Jenatko/VariYO/Doc/chess.png

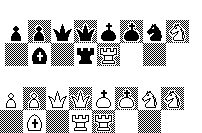
Doc/chess.png
