Jenatko/VariYO/pict/altdisp.jpg

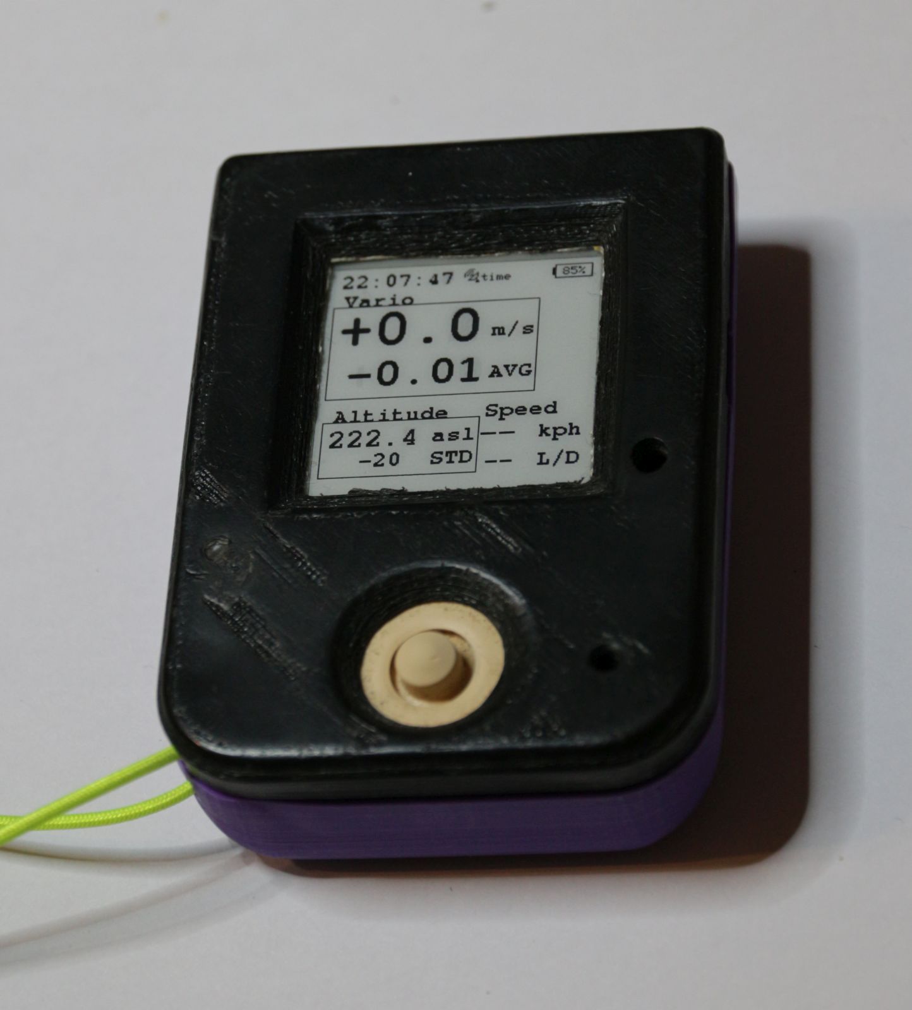
pict/altdisp.jpg
