Jenatko/VariYO/pict/chess.jpg

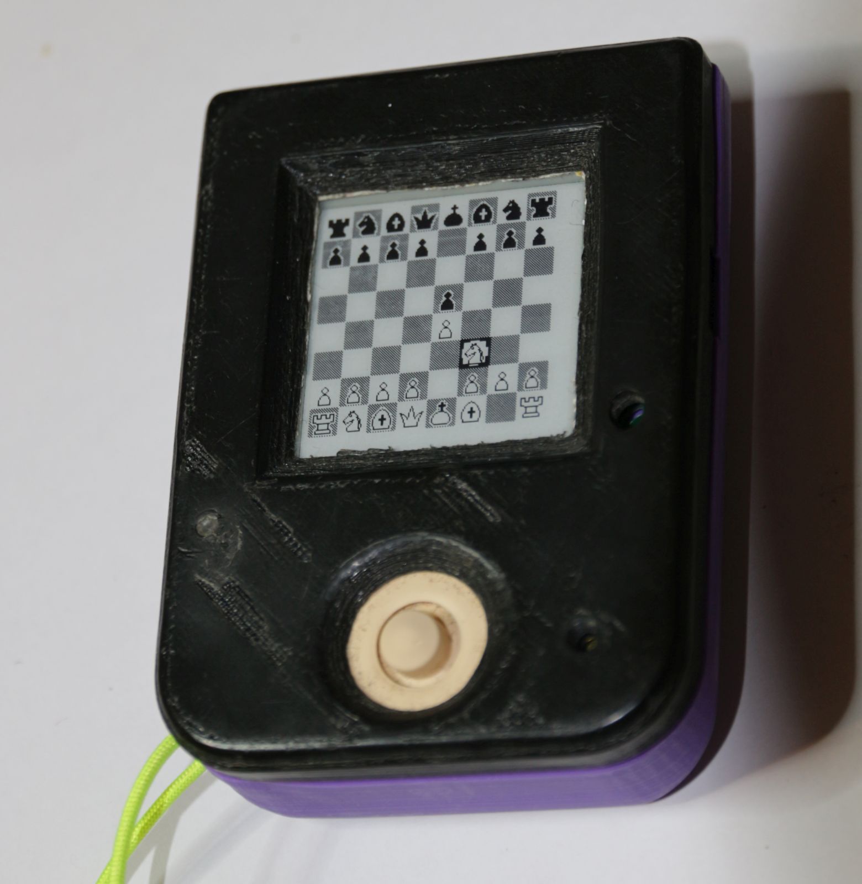
pict/chess.jpg
