Jenatko/VariYO/Hardware/bottom.STL

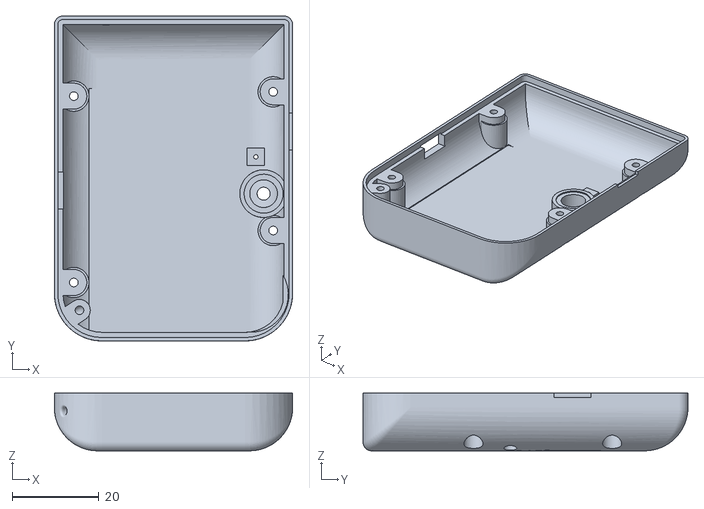
[picture p15: CAD file, 2020-01-19]
Hardware/bottom.STL
55.0 x 75.0 x 13.3
