Jenatko/VariYO/Hardware/top.STL

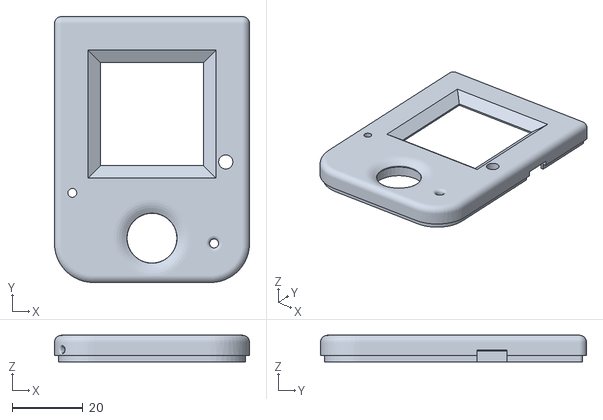
[picture p16: CAD file, 2020-01-19]
Hardware/top.STL
55.0 x 75.0 x 7.50
