Jenatko/VariYO/(list of files, cad)

Other CAD files:
Hardware/forma_joystick.dwg
