Jenatko/VariYO/(threads)

Thread 5 (2024-11-13):

Stencil for the PCB

JohnDoeAkira, 2024-11-13:
Hello,
First : Bravo for the project !
Is there any chance you could release the gerber files needed to order a stencil ?
I believe, these are GTP GBP extensions.
Cheers,
Partrick

Jenatko, 2025-04-01:
Hi, sorry for not responding. Nothing really was happening here for a long time, so i sort of stopped looking, i will have a look at it. I might have a new PCB revision altogether, so will have to somehow sync it.
