Jenatko/VariYO/(list of files, drawings)

Other design files:
Hardware/PCB/SensorsPower.SchDoc
Hardware/PCB/Vario_PCB.PrjPcb
Hardware/PCB/Vario_pcb_2l.PcbDoc
Hardware/PCB/Vario_sch.SchDoc
