Jenatko/VariYO/VarioSW_as/VarioSW/VarioSW.cpp

#include "SPI_IRQ.h"



#include <wiring_private.h>


#include "definitions.h"


#include "button_control.h"

#include "Menu.h"

#include "numpad.h"

#include "RTCZero.h"

#include "buzzer.h"

#include "roundbuff.h"

#include "routine.h"

#include "kalmanfilter3.h"

#include "MAX17055.h"

#include "EEPROM.h"

#include "Variables.h"

#include "powerModes.h"

#include <Wire.h>

#include "MEMS.h"

#include "chess.h"

#include "routine.h"

#include "Gauge.h"

#include "statvar.h"



#define ENABLE_GxEPD2_GFX 0


#include <GxEPD2_BW.h>
#define MAX_DISPAY_BUFFER_SIZE 15000ul // ~15k is a good compromise
#define MAX_HEIGHT(EPD) (EPD::HEIGHT <= MAX_DISPLAY_BUFFER_SIZE / (EPD::WIDTH / 8) ? EPD::HEIGHT : MAX_DISPLAY_BUFFER_SIZE / (EPD::WIDTH / 8))



#include <Fonts/FreeMonoBold24pt7b.h>
#include <Fonts/FreeMonoBold18pt7b.h>
#include <Fonts/FreeMonoBold12pt7b.h>
#include <Fonts/FreeMonoBold9pt7b.h>

#include "Interrupt_counter.h"

#ifdef EPAPER_V2
GxEPD2_BW<GxEPD2_154_D67, GxEPD2_154_D67::HEIGHT> display(GxEPD2_154_D67(/*CS=D8*/ PA13, /*DC=D3*/ PA14, /*RST=D4*/ PA15, /*BUSY=D2*/ PA10));
#else
GxEPD2_BW<GxEPD2_154, GxEPD2_154::HEIGHT> display(GxEPD2_154(/*CS=D8*/ PA13, /*DC=D3*/ PA14, /*RST=D4*/ PA15, /*BUSY=D2*/ PA10));
#endif




#include "SdFat.h"

SdFat SD;

#include "FlashStorage/FlashStorage.h"








volatile int counter_incremented_every_ISR = 0;




void draw_antenna(int x_oirg, int y_orig);
void draw_floppy(int x_orig, int y_orig);

int full_refresh = 0;





void displayUpdate(bool drawall = false){

	//digitalWrite(SRAM_CS, 0);




	if(ground_level != 0xffff)	statVar.AGLGauge.value[active_desktop] = (alt_filter*0.01f) - ground_level;
	else statVar.AGLGauge.value[active_desktop] = NAN;
	
	
	statVar.altitudeGauge.value[active_desktop] = (alt_filter*0.01f);
	statVar.tempGauge.value[active_desktop] = enviromental_data.temperature*0.01f;
	statVar.humidGauge.value[active_desktop] = enviromental_data.humidity;
	
	
	statVar.windGauge.value[active_desktop] = wind_speed_mps;
	statVar.windDirGauge.value[active_desktop] = wind_direction;
	
	statVar.PressureAltGauge.value[active_desktop] = getPressureAltitude();

	
	statVar.MagHdgGauge.value[active_desktop] = yaw;
	
	if(statVar.ena_vector & ENA_TRACKLOG) statVar.flightTimeGauge.value[active_desktop] = (rtc.getEpoch() - var_takeofftime)/60;
	else statVar.flightTimeGauge.value[active_desktop] = NAN;
	//statVar.altAboveTakeoffGauge = ;
	//statVar.glideRatioGauge = ;
	if(statVar.ena_vector & ENA_TRACKLOG) statVar.altAboveTakeoffGauge.value[active_desktop] = alt_filter*0.01f - var_takeoffalt*0.01f;
	else statVar.altAboveTakeoffGauge.value[active_desktop] = NAN;

	digitalWrite(SRAM_CS, 0);
	
	if(full_refresh){
		printGauges();
	}
	else
	printGauges_values();
	

	
	digitalWrite(SRAM_CS, 1);
	

	



	
	display.setCursor(10,110);
	display.setFont(&FreeMonoBold12pt7b);
	

	
	display.setFont(&FreeMonoBold12pt7b);
	
	//	display.updateWindow(0, 0, GxEPD_WIDTH, GxEPD_HEIGHT, true);
	
	//display.partiallyUpdateScreen();
	if(full_refresh)	display.display();

	else 	display.display(true);

	
	full_refresh = 0;

	
	display.fillScreen(GxEPD_WHITE);
	display.setFont(&FreeMonoBold9pt7b);
	display.setCursor(5,12);
	if(var_localtime.tm_hour < 10) display.print("0");
	display.print(var_localtime.tm_hour);
	display.print(":");
	if(var_localtime.tm_min < 10) display.print("0");
	display.print(var_localtime.tm_min);
	display.print(":");
	if(var_localtime.tm_sec < 10) display.print("0");
	display.print(var_localtime.tm_sec);

	
	display.setFont();
	
	draw_antenna(100, 0);
	display.setCursor(113,5);
	//	display.setFont();
	if(statVar.ena_vector & ENA_GPS){
		if(fix.valid.location)
		display.print("3D");
		else if(fix.valid.time)
		display.print("time");
		else
		display.print("No");
	}
	else		display.print("OFF");
	
	if(statVar.ena_vector & ENA_TRACKLOG)	draw_floppy(150, 0);
	
	
	
	
	display.setCursor(176,3);

	display.print(battery_SOC, 0);
	display.print("%");
	display.drawLine(170, 0, 198, 0, GxEPD_BLACK);
	display.drawLine(170, 12, 198, 12, GxEPD_BLACK);
	display.drawLine(170, 0, 170, 12, GxEPD_BLACK);
	display.drawLine(198, 0, 198, 12, GxEPD_BLACK);
	display.drawLine(169, 3, 169, 9, GxEPD_BLACK);
	display.drawLine(168, 3, 168, 9, GxEPD_BLACK);
	
	
	printGauges_frames();
	
	
	display.setFont(&FreeMonoBold12pt7b);


	//redraw = 0;
	
}


void setup() {
	#ifdef WAITATSETUPFORSERIAL
	while(!SerialUSB.available());
	#endif
	
	//while(!SerialUSB.available());

	
	rtc.begin();
	rtc.setTime(0, 0, 0);
	rtc.setDate(1, 1, 19);
	
	pinMode(HEAT, OUTPUT);
	digitalWrite(HEAT, 0);
	
	pinMode(POWER_ENA, OUTPUT);
	digitalWrite(POWER_ENA, POWER_OFF);
	
	pinMode(BT_UART_TX, OUTPUT);
	digitalWrite(BT_UART_TX, 0);
	
	delay(100);
	digitalWrite(POWER_ENA, POWER_ON);
	delay(50);
	
	pinMode(BUTTON_LEFT, INPUT_PULLUP);
	pinMode(BUTTON_RIGHT, INPUT_PULLUP);
	pinMode(BUTTON_UP, INPUT_PULLUP);
	pinMode(BUTTON_DOWN, INPUT_PULLUP);
	pinMode(BUTTON_CENTER, INPUT_PULLUP);


	pinMode(EEPROM_CS, OUTPUT);
	digitalWrite(EEPROM_CS, 1);


	pinMode(SRAM_CS, OUTPUT);
	digitalWrite(SRAM_CS, 1);

	pinMode(SD_CS, OUTPUT);
	digitalWrite(SD_CS, 1);

	pinMode(SD_DETECT, INPUT_PULLUP);

	pinMode(SD_RST, OUTPUT);
	digitalWrite(SD_RST, 0);


	pinMode(IMU_CS, OUTPUT);
	digitalWrite(IMU_CS, 1);
	
	pinMode(BARO_CS, OUTPUT);
	digitalWrite(BARO_CS, 1);

	pinMode(GPS_CS, OUTPUT);
	digitalWrite(GPS_CS, 1);
	
	pinMode(GPS_BCKP, OUTPUT);
	digitalWrite(GPS_BCKP, 1);

	pinPeripheral(MOSI_IRQ, PIO_SERCOM);
	pinPeripheral(MISO_IRQ, PIO_SERCOM);
	pinPeripheral(SCK_IRQ, PIO_SERCOM);



	SPI.begin();

	delay(100);   //wait for EEPROM to power-up
	

	



	
	//BT_off();

	
	present_devices = 0;
	
	


	
	if(statVar.ena_vector & (ENA_GPS)){
		if(statVar.ena_vector & (ENA_GPS_LOW_POWER)){
			GPS_low();
		}
		else{
			GPS_full();
		}
	}
	else{
		GPS_off();
	}
	

	menu_init();



	analogWrite(DAC, statVar.BuzzerVolume);
	Wire.begin();


	#ifdef SERIALDEBUG
	SerialUSB.println("Setting up display:");
	#endif

	display.init(0);
	#ifdef SERIALDEBUG
	SerialUSB.println("  init");
	#endif

	display.setFont(&FreeMonoBold12pt7b);
	#ifdef SERIALDEBUG
	SerialUSB.println("  Font");
	#endif

	display.setTextColor(GxEPD_BLACK);
	#ifdef SERIALDEBUG
	SerialUSB.println("  Text Color");
	#endif

	display.fillScreen(GxEPD_WHITE);
	#ifdef SERIALDEBUG
	SerialUSB.println("  Fill");
	#endif
	
	display.display();

	
	display.setRotation(0);
	#ifdef SERIALDEBUG
	SerialUSB.println("  rotation");
	#endif

	display.display(true);
	#ifdef SERIALDEBUG
	SerialUSB.println("  display(true)");
	#endif

	display.setTextWrap(0);
	#ifdef SERIALDEBUG
	SerialUSB.println("  text warp");
	#endif

	display.setCursor(10, 20);
	display.print("display ok");
	display.display(true);
	#ifdef SERIALDEBUG
	SerialUSB.println("  display ok");
	#endif

	display.setCursor(10, 40);
	#ifdef SERIALDEBUG
	SerialUSB.println("  Check max17055:");
	#endif

	if(max17055.checkFunct()){
		max17055.setResistSensor(0.039);
		max17055.setCapacity(1200);
		display.print("max17055 ok");
		#ifdef SERIALDEBUG
		SerialUSB.println("    max17055 ok");
		#endif
		present_devices |= MAX17055_PRESENT;
		
	}
	else{
		display.print("max17055 NOK");
		#ifdef SERIALDEBUG
		SerialUSB.println("    max17055 NOK");
		#endif

	}
	display.display(true);
	#ifdef SERIALDEBUG
	SerialUSB.println("  End check max17055k");
	#endif


	display.setCursor(10, 60);
	int errorcode = IMU_init();
	if(errorcode==0){
		display.print("BMX160 ok");
		present_devices |= BMX160_PRESENT;
		#ifdef SERIALDEBUG
		SerialUSB.println( MAG_init());
		#endif
	}
	else{
		display.print("BMX160 NOK ");
		display.print(errorcode);
		#ifdef SERIALDEBUG
		SerialUSB.println("  BMX160 NOK");
		#endif

	}
	//present_devices += BMX160_PRESENT;
	display.display(true);
	
	
	display.setCursor(10, 80);
	if(lps33_test()){
		lps33_init();
		display.print("lps33 ok");
		present_devices |= LPS33_PRESENT;
	}
	else{
		display.print("lps33 NOK");
		#ifdef SERIALDEBUG
		SerialUSB.println("lps33 NOK");
		#endif
	}
	display.display(true);
	
	
	display.setCursor(10, 100);
	if(request_si7021() == 0){
		display.print("si7021 ok");
		present_devices |= SI7021_PRESENT;
	}
	else{
		display.print("si7021 NOK");
		#ifdef SERIALDEBUG
		SerialUSB.println("  si7021 NOK");
		#endif
	}
	display.display(true);
	
	#ifdef SERIALDEBUG
	SerialUSB.println("  SD check:");
	#endif

	
	display.setCursor(10, 120);
	int ahoj;
	if(digitalRead(SD_DETECT) == 0){
		display.print("SD present ");
		#ifdef SERIALDEBUG
		SerialUSB.println("    SD present ");
		#endif
		present_devices |= SD_PRESENT;
		
		ahoj = SD.begin(SD_CS, SD_SCK_MHZ(8));
		display.print(ahoj);
		#ifdef SERIALDEBUG
		SerialUSB.println(ahoj);
		#endif
		
	}
	else{
		display.print("no SD card");
		#ifdef SERIALDEBUG
		SerialUSB.println("    no SD card");
		#endif

	}
	pinMode(SD_DETECT, INPUT);
	display.display(true);
	
load_statvar();

	
	display.setCursor(10, 140);
	
	display.print("eeprom used:");
	display.setCursor(10, 160);
	display.print(sizeof(statVar));
	display.print("/");
	display.print(4096/8/sizeof(char));
	
	display.display(true);
	
	display.setCursor(10, 180);
	display.print(__DATE__);
	display.display(true);
	
	
	
	


	delay(1000);
	while(!digitalRead(BUTTON_CENTER));
	
	
	#ifdef SERIALDEBUG
	SerialUSB.println("  Buzzer");
	#endif
	

	buzzerInit();


	
	counterInit();
	
	delay(1000);
	
	
	//setVariablesDefault();

	#ifdef SERIALDEBUG
	SerialUSB.println("  kalman filter");
	#endif


	kalmanFilter3_configure(statVar.zvariance*1.0f, statVar.accelvariance*1000.0f, 1.0f, alt_baro*1.0f, 0.0f , 0.0f);
	
	vario_lowpassed_600samples = 0;

	
	

	#ifdef SERIALDEBUG
	SerialUSB.println("Setup done.");
	#endif
	
	debugflag = 0;


}



void loop() {


	while (buttons.getFlag()){
		switch (buttons.getButtonPressed()){
			case PRESS:
			MenuEntry(&topmenu);
			display.fillScreen(GxEPD_WHITE);

			//	displayUpdate(true);
			//	display.display();
			full_refresh = 1;
			break;
			
			case DOWN:
			statVar.BuzzerVolume -=30;
			if(statVar.BuzzerVolume<=0){
				statVar.BuzzerVolume = 0;
				
			}
			buzzerSetVolume(statVar.BuzzerVolume);
			break;
			
			case UP:
			statVar.BuzzerVolume +=30;
			if(statVar.BuzzerVolume>255){
				statVar.BuzzerVolume = 255;
				
			}
			buzzerSetVolume(statVar.BuzzerVolume);
			break;
			case LEFT:
			active_desktop--;
			if(active_desktop<0){
				active_desktop = NUM_DESKTOPS - 1;
				
			}
			break;
			case RIGHT:
			active_desktop++;
			if(active_desktop>NUM_DESKTOPS-1){
				active_desktop = 0;
				
			}
			
			buzzerSetVolume(statVar.BuzzerVolume);
			break;
		}

	}
	
	uint64_t t_start_first = micros();
	routine(0);
	uint64_t t_stop_first = micros();
	//	SerialUSB.println((uint32_t)((t_stop-t_start)/1000));


	if(digitalRead(DISP_BUSY) == 0){
		time_t tempTime = rtc.getEpoch();
		tempTime += 3600 * statVar.TimeZone;
		var_localtime = *gmtime(&tempTime);
		
		
		t_start_first = micros();
		
		displayUpdate();
		t_stop_first = micros();
	}
	else{
		delay(10);
	}
}


void draw_antenna(int x_orig, int y_orig){
	display.drawLine(x_orig + 4, y_orig, x_orig + 7, y_orig, GxEPD_BLACK);
	display.drawLine(x_orig, y_orig+4, x_orig, y_orig+7, GxEPD_BLACK);
	display.drawLine(x_orig+1, y_orig+3, x_orig+3, y_orig+1, GxEPD_BLACK);
	
	display.drawLine(x_orig+2, y_orig+5, x_orig+5, y_orig+2, GxEPD_BLACK);
	display.drawPixel(x_orig+2, y_orig+6, GxEPD_BLACK);
	display.drawPixel(x_orig+6, y_orig+2, GxEPD_BLACK);
	
	display.drawLine(x_orig+6, y_orig+4, x_orig+4, y_orig+6, GxEPD_BLACK);
	
	display.drawLine(x_orig+10, y_orig+3, x_orig+3, y_orig+10, GxEPD_BLACK);
	display.drawLine(x_orig+10, y_orig+4, x_orig+10, y_orig+7, GxEPD_BLACK);
	display.drawLine(x_orig+4, y_orig+10, x_orig+7, y_orig+10, GxEPD_BLACK);
	
	display.drawPixel(x_orig+11, y_orig+11, GxEPD_BLACK);
	display.drawPixel(x_orig+10, y_orig+10, GxEPD_BLACK);
	display.drawPixel(x_orig+10, y_orig+11, GxEPD_BLACK);
	display.drawPixel(x_orig+9, y_orig+11, GxEPD_BLACK);
	display.drawPixel(x_orig+9, y_orig+9, GxEPD_BLACK);
	display.drawPixel(x_orig+9, y_orig+8, GxEPD_BLACK);
	display.drawPixel(x_orig+8, y_orig+9, GxEPD_BLACK);
	display.drawPixel(x_orig+6, y_orig+6, GxEPD_BLACK);
	display.drawPixel(x_orig+11, y_orig+12, GxEPD_BLACK);
	display.drawPixel(x_orig+10, y_orig+12, GxEPD_BLACK);
	display.drawPixel(x_orig+9, y_orig+12, GxEPD_BLACK);
}

void draw_floppy(int x_orig, int y_orig){
	display.drawLine(x_orig, y_orig, x_orig + 11, y_orig, GxEPD_BLACK);
	display.drawLine(x_orig, y_orig, x_orig, y_orig+10, GxEPD_BLACK);
	display.drawLine(x_orig+11, y_orig, x_orig + 11, y_orig+11, GxEPD_BLACK);
	display.drawLine(x_orig+1, y_orig+11, x_orig + 11, y_orig+11, GxEPD_BLACK);
	display.drawLine(x_orig+2, y_orig+1, x_orig + 2, y_orig+6, GxEPD_BLACK);
	display.drawLine(x_orig+9, y_orig+1, x_orig + 9, y_orig+6, GxEPD_BLACK);
	display.drawLine(x_orig+2, y_orig+6, x_orig + 9, y_orig+6, GxEPD_BLACK);
	
	display.drawLine(x_orig+3, y_orig+8, x_orig + 8, y_orig+8, GxEPD_BLACK);
	display.drawPixel(x_orig+3, y_orig+9, GxEPD_BLACK);
	display.drawPixel(x_orig+3, y_orig+10, GxEPD_BLACK);
	display.drawPixel(x_orig+6, y_orig+9, GxEPD_BLACK);
	display.drawPixel(x_orig+6, y_orig+10, GxEPD_BLACK);
	display.drawPixel(x_orig+7, y_orig+10, GxEPD_BLACK);
	display.drawPixel(x_orig+7, y_orig+9, GxEPD_BLACK);
	display.drawPixel(x_orig+8, y_orig+9, GxEPD_BLACK);
	display.drawPixel(x_orig+8, y_orig+10, GxEPD_BLACK);

}
