Jenatko/VariYO/Serial/serial_reader/serial_plotter.py

from PyQt5.QtGui import QIntValidator
from PyQt5.QtWidgets import QGridLayout, QApplication, QPushButton, QLineEdit
from qtpy import QtWidgets

from matplot_vidgets import MplWidget
import serial

import numpy as np


class SerialPlotter(QtWidgets.QWidget):

    FREQ = 4800

    def __init__(self, port=None):
        super(SerialPlotter, self).__init__()

        self.setLayout(QGridLayout(self))

        self.grid = []

        self.mpl = MplWidget(dpi=100)
        self.mpl.toolbar.show()
        self.layout().addWidget(self.mpl, 0, 0)

        self.iterationsLabel = QLineEdit()
        self.iterationsLabel.setText('600')
        self.iterationsLabel.setValidator(QIntValidator(0,1000))
        self.layout().addWidget(self.iterationsLabel, 1, 0)

        button = QPushButton('Read shit!')
        button.clicked.connect(self.read)
        self.layout().addWidget(button, 2, 0)

        self.port = port

    def check_connection(self):

        if self.port is None:
            port, flag = self.scan_connections()
            if flag:
                self.port = port
                return True
            else:
                print('Vario not connected.')
                return False
        else:
            return True

    def read(self):

        if not self.check_connection():
            return

        iterations = int(self.iterationsLabel.text())

        with serial.Serial(self.port, self.FREQ, timeout=5) as ser:
            print('Vario connected at port:', self.port)
            cache = []
            try:
                for i in range(iterations):
                    line = ser.readline()
                    if line:
                        print(line.strip())
                        cache.append(float(line))
                    else:
                        print('Reading data failed.')
                        return

            except Exception as ex:
                print(ex)

            if len(cache) > 1:
                std = np.std(cache)
                self.mpl.sc.axes.plot(cache, label='std = {:0.3e}'.format(std))
                self.mpl.sc.fig.legend()
                self.mpl.sc.draw()
            else:
                print('Reading data failed.')

    def scan_connections(self):

        flag_found = False
        print("Looking for ports.")
        for i in range(2, 30):
            COM0 = "COM" + repr(i)
            print("\tConnecting to port {:s}...".format(COM0), end='')
            try:
                ser = serial.Serial(COM0, self.FREQ)
                ser.close()
            except Exception as ex:
                print("Not this one.")
            else:
                flag_found = True
                print("Found open port: ", COM0)
                break
        print("Done.\n")
        if flag_found:
            print("Found open port: ", COM0)
        else:
            print('No port available.')
        return COM0, flag_found


if __name__ == "__main__":

    import sys

    port = None
    if len(sys.argv) > 1:
        port = sys.argv[1]

    app = QApplication([])

    window = SerialPlotter(port)
    window.show()
    sys.exit(app.exec_())
