Jenatko/VariYO/VarioSW_as/VarioSW/src/periph/MAX17055.cpp

/**********************************************************************
*
* MIT License
*
* Copyright (c) 2018 Awot Ghirmai
*
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
* Authors:
* Awot Ghirmai; ghirmai.awot@gmail.com
* Ole Dreessen; ole.dreessen@maximintegrated.com
*
**********************************************************************/


#include <MAX17055.h>
#include <Wire.h>
 
 
 /**********************************************************************
 * @brief MAX17055 - The MAX17055 is a low 7?A operating current fuel gauge that implements
 * Maxim ModelGauge™ m5 EZ algorithm. ModelGauge m5 EZ makes fuel gauge implementation
 * easy by eliminating battery characterization requirements and simplifying host software interaction.
 * The ModelGauge m5 EZ robust algorithm provides tolerance against battery diversity for most
 * lithium batteries and applications. ModelGauge m5 EZ algorithm combines the short-term
 * accuracy and linearity of a coulomb counter with the longterm stability of a voltage-based fuel
 * gauge, along with temperature compensation to provide industry-leading fuel gauge accuracy.
 * The MAX17055 automatically compensates for cell aging, temperature, and discharge rate, and
 * provides accurate state of charge (SOC in %) and remaining capacity in milliampere-hours (mAh).
 * As the battery approaches the critical region near empty, the ModelGauge m5 algorithm invokes
 * a special compensation that eliminates any error. It also provides three methods for reporting
 * the age of the battery: reduction in capacity, increase in battery resistance, and cycle odometer.
 * The MAX17055 provides precision measurements of current, voltage, and temperature. Temperature
 * of the battery pack is measured using an internal temperature measurement or external thermistor.
 * A 2-wire I2C interface provides access to data and control registers. The MAX17055 is available
 * in a tiny, lead-free 0.4mm pitch 1.4mm x 1.5mm, 9-pin WLP package, and a 2mm x 2.5mm, 10-pin
 * TDFN package.
 *
 * Ressources can be found at
 * https://www.maximintegrated.com/en/products/power/battery-management/MAX17055.html
 * https://www.maximintegrated.com/en/app-notes/index.mvp/id/6365
 * https://www.maximintegrated.com/en/app-notes/index.mvp/id/6358
 **********************************************************************/


// Constructors 
MAX17055::MAX17055(void)


  
{
	//doesn't need anything here
}

MAX17055::MAX17055(uint16_t batteryCapacity)
{
	//calcuation based on AN6358 page 13 figure 1.3 for Capacity, but reversed to get the register value 
		writeReg16Bit(ModelCFG, 0);
	writeReg16Bit(DesignCap, batteryCapacity*2);
}
// Public Methods
void MAX17055::setCapacity(uint16_t batteryCapacity)
{
			writeReg16Bit(ModelCFG, 0x8000);
	//calcuation based on AN6358 page 13 figure 1.3 for Capacity, but reversed to get the register value 
	writeReg16Bit(DesignCap, batteryCapacity / capacity_multiplier_mAH);	
}	

float MAX17055::getCapacity()
{
   	// uint16_t capacity_raw = readReg16Bit(RepCap);
   	uint16_t capacity_raw = readReg16Bit(DesignCap);
	return (capacity_raw * capacity_multiplier_mAH);
}

	float MAX17055::getReportedCapacity()
{
	// uint16_t capacity_raw = readReg16Bit(RepCap);
	uint16_t capacity_raw = readReg16Bit(FullCapRep);
	return (capacity_raw * capacity_multiplier_mAH);
}	
	
	float MAX17055::getRemainingCapacity()
{
	// uint16_t capacity_raw = readReg16Bit(RepCap);
	uint16_t capacity_raw = readReg16Bit(RepCap);
	return (capacity_raw * capacity_multiplier_mAH);
}

void MAX17055::setResistSensor(float resistorValue)
{
	resistSensor = resistorValue;
	 capacity_multiplier_mAH = (5e-3)/resistSensor; //refer to row "Capacity"
	 current_multiplier_mV = (1.5625e-3)/resistSensor; //refer to row "Current"
	 voltage_multiplier_V = 7.8125e-5; //refer to row "Voltage"
	 time_multiplier_Hours = 5.625/3600.0; //Least Significant Bit= 5.625 seconds, 3600 converts it to Hours. refer to AN6358 pg 13 figure 1.3 in row "Time"
	 percentage_multiplier = 1.0/256.0; //refer to row "Percentage"
}

float MAX17055::getResistSensor()
{
	return resistSensor;
}

float MAX17055::getInstantaneousCurrent()
{
   	int16_t current_raw = readReg16Bit(Current);
	return current_raw * current_multiplier_mV;
}

float MAX17055::getAverageCurrent()
{
	int16_t current_raw = readReg16Bit(AvgCurrent);
	return current_raw * current_multiplier_mV;
}

float MAX17055::getInstantaneousVoltage()
{
   	uint16_t voltage_raw = readReg16Bit(VCell);
	return voltage_raw * voltage_multiplier_V;
}

float MAX17055::getAverageVoltage()
{
	uint16_t voltage_raw = readReg16Bit(AvgVCell);
	return voltage_raw * voltage_multiplier_V;
}

float MAX17055::getSOC()
{
   	uint16_t SOC_raw = readReg16Bit(RepSOC);
	return SOC_raw * percentage_multiplier;
}

float MAX17055::getTimeToEmpty()
{
	uint16_t TTE_raw = readReg16Bit(TimeToEmpty);
	return TTE_raw * time_multiplier_Hours;
}

float MAX17055::getTimeToFull()
{
	uint16_t TTE_raw = readReg16Bit(TimeToFull);
	return TTE_raw * time_multiplier_Hours;
}

float MAX17055::getTemp()
{
	int16_t TTE_raw = readReg16Bit(Temp);
	return TTE_raw/256.0;
}

float MAX17055::getVFSOC(){
   	uint16_t SOC_raw = readReg16Bit(VFSOC);
   	return SOC_raw * percentage_multiplier;
	
}

int MAX17055::checkFunct(){
writeReg16Bit(Rsense, 0xaabb);
int readvalue = readReg16Bit(Rsense);
if(readvalue == 0xaabb)
return 1;
else
return 0;
}



// Private Methods

void MAX17055::writeReg16Bit(uint8_t reg, uint16_t value)
{
  //Write order is LSB first, and then MSB. Refer to AN635 pg 35 figure 1.12.2.5
  Wire.beginTransmission(I2CAddress);
  Wire.write(reg);
  Wire.write( value       & 0xFF); // value low byte
  Wire.write((value >> 8) & 0xFF); // value high byte
  uint8_t last_status = Wire.endTransmission();
}

uint16_t MAX17055::readReg16Bit(uint8_t reg)
{
  uint16_t value = 0;  
  Wire.beginTransmission(I2CAddress); 
  Wire.write(reg);
  uint8_t last_status = Wire.endTransmission(false);
  
  Wire.requestFrom(I2CAddress, (uint8_t) 2); 
  value  = Wire.read();
  value |= (uint16_t)Wire.read() << 8;      // value low byte
  return value;
}

MAX17055 max17055;
