Jenatko/VariYO/VarioSW_as/ArduinoCore/src/core/wiring_digital.c

/*
  Copyright (c) 2015 Arduino LLC.  All right reserved.

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
  You should have received a copy of the GNU Lesser General Public
  License along with this library; if not, write to the Free Software
  Foundation, Inc., 51 Franklin St, Fifth Floor, Boston, MA  02110-1301  USA
*/

#include "Arduino.h"

#ifdef __cplusplus
 extern "C" {
#endif

void pinMode( uint32_t ulPin, uint32_t ulMode )
{
  // Handle the case the pin isn't usable as PIO
  if ( g_APinDescription[ulPin].ulPinType == PIO_NOT_A_PIN )
  {
    return ;
  }

  // Set pin mode according to chapter '22.6.3 I/O Pin Configuration'
  switch ( ulMode )
  {
    case INPUT:
      // Set pin to input mode
      PORT->Group[g_APinDescription[ulPin].ulPort].PINCFG[g_APinDescription[ulPin].ulPin].reg=(uint8_t)(PORT_PINCFG_INEN) ;
      PORT->Group[g_APinDescription[ulPin].ulPort].DIRCLR.reg = (uint32_t)(1<<g_APinDescription[ulPin].ulPin) ;
    break ;

    case INPUT_PULLUP:
      // Set pin to input mode with pull-up resistor enabled
      PORT->Group[g_APinDescription[ulPin].ulPort].PINCFG[g_APinDescription[ulPin].ulPin].reg=(uint8_t)(PORT_PINCFG_INEN|PORT_PINCFG_PULLEN) ;
      PORT->Group[g_APinDescription[ulPin].ulPort].DIRCLR.reg = (uint32_t)(1<<g_APinDescription[ulPin].ulPin) ;

      // Enable pull level (cf '22.6.3.2 Input Configuration' and '22.8.7 Data Output Value Set')
      PORT->Group[g_APinDescription[ulPin].ulPort].OUTSET.reg = (uint32_t)(1<<g_APinDescription[ulPin].ulPin) ;
    break ;

    case INPUT_PULLDOWN:
      // Set pin to input mode with pull-down resistor enabled
      PORT->Group[g_APinDescription[ulPin].ulPort].PINCFG[g_APinDescription[ulPin].ulPin].reg=(uint8_t)(PORT_PINCFG_INEN|PORT_PINCFG_PULLEN) ;
      PORT->Group[g_APinDescription[ulPin].ulPort].DIRCLR.reg = (uint32_t)(1<<g_APinDescription[ulPin].ulPin) ;

      // Enable pull level (cf '22.6.3.2 Input Configuration' and '22.8.6 Data Output Value Clear')
      PORT->Group[g_APinDescription[ulPin].ulPort].OUTCLR.reg = (uint32_t)(1<<g_APinDescription[ulPin].ulPin) ;
    break ;

    case OUTPUT:
      // Set pin to output mode
      PORT->Group[g_APinDescription[ulPin].ulPort].PINCFG[g_APinDescription[ulPin].ulPin].reg&=~(uint8_t)(PORT_PINCFG_INEN) ;
	  PORT->Group[g_APinDescription[ulPin].ulPort].DIRSET.reg = (uint32_t)(1<<g_APinDescription[ulPin].ulPin) ;
	  PORT->Group[g_APinDescription[ulPin].ulPort].PINCFG[g_APinDescription[ulPin].ulPin].bit.DRVSTR = 1;


    break ;

    default:
      // do nothing
    break ;
  }
}

void digitalWrite( uint32_t ulPin, uint32_t ulVal )
{
  // Handle the case the pin isn't usable as PIO
  if ( g_APinDescription[ulPin].ulPinType == PIO_NOT_A_PIN )
  {
    return ;
  }

  // Enable pull-up resistor
  PORT->Group[g_APinDescription[ulPin].ulPort].PINCFG[g_APinDescription[ulPin].ulPin].reg=(uint8_t)(PORT_PINCFG_PULLEN) ;

  switch ( ulVal )
  {
    case LOW:
      PORT->Group[g_APinDescription[ulPin].ulPort].OUTCLR.reg = (1ul << g_APinDescription[ulPin].ulPin) ;
    break ;

    default:
      PORT->Group[g_APinDescription[ulPin].ulPort].OUTSET.reg = (1ul << g_APinDescription[ulPin].ulPin) ;
    break ;
  }

  return ;
}

int digitalRead( uint32_t ulPin )
{
  // Handle the case the pin isn't usable as PIO
  if ( g_APinDescription[ulPin].ulPinType == PIO_NOT_A_PIN )
  {
    return LOW ;
  }

  if ( (PORT->Group[g_APinDescription[ulPin].ulPort].IN.reg & (1ul << g_APinDescription[ulPin].ulPin)) != 0 )
  {
    return HIGH ;
  }

  return LOW ;
}

#ifdef __cplusplus
}
#endif
