Jenatko/VariYO/VarioSW_as/VarioSW/src/Variables.h

/*
* Variables.h
*
* Created: 1.12.2018 16:55:05
*  Author: Jena
*/
#include <Arduino.h>
#include <time.h>
#include <bme280_defs.h>


#include "lib/CircleFit/circle.h"
#include "lib/CircleFit/data.h"
#include "definitions.h"


#ifndef VARIABLES_H_
#define VARIABLES_H_





typedef struct Gauge{
	float value[NUM_DESKTOPS];
	uint16_t settings[NUM_DESKTOPS];
	uint8_t size_X[NUM_DESKTOPS];
	uint8_t size_Y[NUM_DESKTOPS];
	uint8_t offset_X[NUM_DESKTOPS];
	uint8_t offset_Y[NUM_DESKTOPS];
	char name_shown[NUM_DESKTOPS][10];
	char units[NUM_DESKTOPS][4];
	uint16_t averaging[NUM_DESKTOPS];
} Gauge;



typedef struct StaticVariables{
	int8_t valid;
	int16_t th_rise;
	int16_t th_sink;
	int8_t ena_vector;
	int16_t BuzzerVolume;
	int8_t TimeZone;
	
	//MS5611 baro
	float Psea;
	
	
	//IMU
	float gainErrorAccelX;
	int16_t offsetAccelX;
	float gainErrorAccelY;
	int16_t offsetAccelY;
	float gainErrorAccelZ;
	int16_t offsetAccelZ;
	
	int gainErrorMagX;
	int offsetMagX;
	int gainErrorMagY;
	int offsetMagY;
	int gainErrorMagZ;
	int offsetMagZ;
	

	
	float zvariance, accelvariance;
	Gauge varioGauge;
	Gauge varioAvgGauge;
	Gauge altitudeGauge;
	Gauge AGLGauge;
	Gauge speedGauge;
	Gauge headingGauge;
	Gauge tempGauge;
	Gauge humidGauge;
	Gauge windGauge;
	Gauge windDirGauge;
	Gauge glideRatioGauge;
	Gauge flightTimeGauge;
	Gauge altAboveTakeoffGauge;
	Gauge PressureAltGauge;
	Gauge MagHdgGauge;
	
	
} StaticVariables;

struct enviroData {
	/*! Compensated pressure */
	uint32_t pressure;
	/*! Compensated temperature */
	int32_t temperature;
	/*! Compensated humidity */
	uint32_t humidity;
};


extern int active_desktop ;

extern double myRealAltitude;
extern volatile float altChange, vario_lowpassed_600samples;
//extern int redraw;
extern volatile int ax, ay, az, ax_corr, ay_corr, az_corr, gx, gy, gz, ax_avg, ay_avg, az_avg, gx_avg, gy_avg, gz_avg, mx, my, mz, mx_cor, my_cor, mz_cor, axmax, aymax, azmax, gxmax, gymax, gzmax, axmin, aymin, azmin, gxmin, gymin, gzmin, debugflag;
extern float yaw, pitch, roll;
extern float a_vertical_imu, alt_filter, vario_filter, alt_baro;

extern int tracklog_stat;
//extern struct tm*  var_localtime;
extern struct tm  var_localtime;
extern time_t  var_takeofftime;
extern int var_takeoffalt;
extern float g_meter;
extern int ground_level, ground_level2;
extern int PerformRoutineInWaitWhileBusy;
extern int position_updated;
extern int serialDebugVector;


extern float ground_level_interpol;

extern uint8_t present_devices;

extern float battery_voltage, battery_SOC;

extern int logger_ena;

extern int maxalt ;
extern int minalt ;
extern int maxrise10s;
extern int minsink10s ;


//for debugging, can be moved to their proper scope after
extern int x1y1, x2y1, x1y2, x2y2, alt11, alt12, alt21, alt22;
extern float fractx, fracty, x1inter, x2inter, interpolation;
extern float lat_dr, lon_dr;



//variables for counting wind
extern float wind_speed_mps;
extern float wind_direction;
extern Data movement_vector_data;
extern Circle movement_circle_fit;


//structure containng pressure, humidity and temperature
extern struct enviroData enviromental_data;



extern StaticVariables statVar;

void setVariablesDefault(void);


#endif /* VARIABLES_H_ */
