Jenatko/VariYO/VarioSW_as/VarioSW/src/periph/BMI160/BMI160Gen.cpp

#include "BMI160Gen.h"
//#include "SPI.h"
#include "SPI_IRQ.h"
#include "Wire.h"

//#define DEBUG

bool BMI160GenClass::begin(const int spi_cs_pin, const int intr_pin)
{
	return begin(SPI_MODE, spi_cs_pin, intr_pin);
}

bool BMI160GenClass::begin(Mode mode, const int arg1, const int arg2)
{
	this->mode = mode;
	switch (this->mode) {
		case INVALID_MODE:

		return false;
		case I2C_MODE:
		i2c_addr = arg1;
		break;
		case SPI_MODE:

		spi_ss = arg1;
		break;
		default:

		return false;
	}
	if (0 <= arg2) {

		interrupt_pin = digitalPinToInterrupt(arg2);
		#ifdef DEBUG
		#endif
	}
	
	return CurieIMUClass::begin();
}

void BMI160GenClass::attachInterrupt(void (*callback)(void))
{
	CurieIMUClass::attachInterrupt(NULL);
	if (0 <= interrupt_pin) {
		::attachInterrupt(interrupt_pin, callback, FALLING);
		} else {
		Serial.println("BMI160GenClass::attachInterrupt: No valid interruption pin.");
	}
}

void BMI160GenClass::ss_init()
{	
	

	switch (this->mode) {
		case I2C_MODE:

		i2c_init();
		break;
		case SPI_MODE:


		spi_init();
		break;
		default:


		break;
	}
}

int BMI160GenClass::ss_xfer(uint8_t *buf, unsigned tx_cnt, unsigned rx_cnt)
{
	switch (this->mode) {
		case I2C_MODE:
		return i2c_xfer(buf, tx_cnt, rx_cnt);
		case SPI_MODE:
		if (rx_cnt) /* For read transfers, assume 1st byte contains register address */
		buf[0] |= (1 << BMI160_SPI_READ_BIT);
		return spi_xfer(buf, tx_cnt, rx_cnt);
		default:
		return 0;
	}
}

void BMI160GenClass::i2c_init()
{
	#ifdef DEBUG
	Serial.println("BMI160GenClass::i2c_init()...");
	#endif // DEBUG

	Wire.begin();
	Wire.beginTransmission(i2c_addr);
	if( Wire.endTransmission() != 0 )
	Serial.println("BMI160GenClass::i2c_init(): I2C failed.");

	#ifdef DEBUG
	int id = getDeviceID();
	Serial.print("BMI160GenClass::i2c_init(): CHIP ID = 0x");
	Serial.println(id, HEX);
	Serial.println("BMI160GenClass::i2c_init()...done");
	#endif // DEBUG
}

int BMI160GenClass::i2c_xfer(uint8_t *buf, unsigned tx_cnt, unsigned rx_cnt)
{
	uint8_t *p;

	#ifdef DEBUG
	Serial.print("i2c_xfer(offs=0x");
	Serial.print(*buf, HEX);
	Serial.print(", tx=");
	Serial.print(tx_cnt);
	Serial.print(", rx=");
	Serial.print(rx_cnt);
	Serial.print("):");
	#endif // DEBUG

	Wire.beginTransmission(i2c_addr);
	p = buf;
	while (0 < tx_cnt) {
		tx_cnt--;
		Wire.write(*p++);
	}
	if( Wire.endTransmission() != 0 ) {
		Serial.println("Wire.endTransmission() failed.");
	}
	if (0 < rx_cnt) {
		Wire.requestFrom(i2c_addr, rx_cnt);
		p = buf;
		while ( Wire.available() && 0 < rx_cnt) {
			rx_cnt--;
			#ifdef DEBUG
			int t = *p++ = Wire.read();
			Serial.print(" ");
			Serial.print(t, HEX);
			#else
			*p++ = Wire.read();;
			#endif // DEBUG
		}
	}

	#ifdef DEBUG
	Serial.println("");
	#endif // DEBUG

	return (0);
}

void BMI160GenClass::spi_init()
{
	#ifdef DEBUG
	SerialUSB.println("BMI160GenClass::spi_init()...");
	#endif // DEBUG


	// start the SPI library:
	//SPI_IRQ.begin();
	if (0 <= spi_ss) {
		pinMode(spi_ss, OUTPUT);
		} else {
		Serial.println("BMI160GenClass::spi_init(): WARNING: No chip select pin specified.");
	}


	#ifdef DEBUG
	Serial.println("BMI160GenClass::spi_init()...done");
	#endif // DEBUG
}

int BMI160GenClass::spi_xfer(uint8_t *buf, unsigned tx_cnt, unsigned rx_cnt)
{	
	SPI_IRQ.beginTransaction(SPISettings(1000000, MSBFIRST, SPI_MODE3));
	uint8_t *p;
	





	if (0 <= spi_ss)
	digitalWrite(spi_ss, LOW);
	p = buf;
	while (0 < tx_cnt) {
		tx_cnt--;
		SPI_IRQ.transfer(*p++);

	}
	p = buf;
	while (0 < rx_cnt) {
		rx_cnt--;
		#ifdef DEBUG
		int t = *p++ = SPI_IRQ.transfer(0);
		Serial.print(" ");
		Serial.print(t, HEX);
		#else
		*p++ = SPI_IRQ.transfer(0);
		#endif // DEBUG
	}
	if (0 <= spi_ss)
	digitalWrite(spi_ss, HIGH);

	#ifdef DEBUG
	Serial.println("");
	#endif // DEBUG

	return (0);
}

BMI160GenClass BMI160;
