Jenatko/VariYO/VarioSW_as/VarioSW/ToDo.h

/*
 * ToDo.h
 *
 * Created: 18.5.2019 21:59:51
 *  Author: Jena
 */ 


#ifndef TODO_H_
#define TODO_H_

/*

printing to display is SLOOOOOOOOWWWWW!!!!
nothing with bluetooth is done yet
some XContest compatible tracklog format (or convert on pc?)
display heating  --partially done, maybe some automatic mode?
airspaces? there is some open airspace format, maybe with that
alarm, stopwatch, countdown timer
chess is super lame, maybe some exit button, not returning when king is taken:-)
temperature/humdity logger
gps to galileo instead of beidou?
turning off all the unnecessary shit in microcontroller would be handy to reduce consumption
check why MAX17055 doesnt indicate SOC 100%
altitude above take-off
compass (indicating towards horizon, yaw indicates top of vario, shows bullshit when vertically on riser)
SW reset
adjustable equation for buzzer (that quadratic a^2 * vario + b*vario + c = buzzer frequency)?
some font with less horizontal spacing (biggest one takes fucktone of space)
full refresh from time to time
adujstable size of buffer for calculating wind, somehow limit it for reasonable values
option to skip writing of values to tracklog if velocity, speed and vario the same (tracklog gets crazy big, and these points add no additional info when moving on the straight line, only first and last point sufficient)
tracklog debug on/off option for writing all these <note> values
more "desktops"?
dark mode?
graph of altitude in past xy minutes
numpad can not return floats (even though there is decimal point prepared:-)), can overflow, maybe could have parameter to show units (eg when putting sea level pressure, there could be "Pa" shown, so you dont put there hPa)
having menu that can have some items not detailed and some items detailed would be fucking awesome


*/


#endif /* TODO_H_ */
