Jenatko/VariYO/VarioSW_as/VarioSW/src/routine.h

/*
 * routine.h
 *
 * Created: 16/10/2018 22:39:56
 *  Author: Jena
 */ 


#ifndef ROUTINE_H_
#define ROUTINE_H_

#include <NMEAGPS.h>
#include <GPSport.h>
#include <Streamers.h>

extern NMEAGPS  gps;
extern gps_fix  fix;


void routine(int pollGPS = 0);

void update_tracklog(void);

void update_wind(void);

void alt_agl(void);

void redrawRoutine(void);


float calcDistanceFromCoordinates(double latHome, double lonHome, double latDest, double lonDest);

float calcHeadingFromCoordinates(double latHome, double lonHome, double latDest, double lonDest);


#endif /* ROUTINE_H_ */
