Jenatko/VariYO/(commit log)

2018-10-14 bofore restructuralizing SW in FSM way
    [arduino_zero.cfg]
2019-06-12 Added option to set fixed number of digits instead of fixed number of decimals
    [Menu.cpp, Variables.cpp, Variables.h]
2019-06-24 Hopeflly fixed opening .hgt files maybe fixed intrpolation in ght files variables in interrupr changed to volatile fixed calling of sd.begin prepared menu for calling ellipsoid fit
    [BMI160Gen.h, Interrupt_counter.cpp, Interrupt_counter.h, Menu.cpp, Variables.cpp, Variables.h, VarioSW.cpp, powerModes.cpp]
2019-06-26 almost implemented ellipsoid fit co correct accelerometer
    [Menu.cpp, VarioSW.cpp]
2019-06-26 minor fixes (swapped axes in accel offset, fixed ellipsoid header file)
    [Menu.cpp]
2019-06-27 added magnetometer calibration, added compass function
2019-07-16 kalman filter updated with 100hz frequency (living by i-have-enough-conputation-time-available fallacy), fixed browsing through detailed menu
    [Interrupt_counter.cpp, Menu.cpp, ToDo.h]
2019-07-16 Changed accelerometer range to 4G
2019-09-16 Changed SD library to SdFat library, hoping to solve all of my problem
    [VarioSW.cpp, powerModes.cpp, routine.cpp]
2019-09-22 Still fucking fixing bugs, added some more gauges, added averaging to gauges. There is bug in L/D gauge, will fix i hope:-)
    [Interrupt_counter.cpp, Menu.cpp, Menu.h, Variables.cpp, Variables.h, definitions.h, powerModes.cpp, routine.cpp]
2019-09-22 Hopefully fixed the L/D calculation
    [Interrupt_counter.cpp, Menu.cpp, routine.cpp]
2019-10-05 Fixed another big freezing the uC on waking up (collision of SPI access in main pprogram and ISR)
    [Menu.cpp, VarioSW.cpp, powerModes.cpp]
2019-11-29 fixed programovani.py to work with python2.7, some minor updates to sw a guess
    [Interrupt_counter.cpp, MEMS.cpp, MEMS.h, Menu.cpp, Variables.cpp, Variables.h, VarioSW.cpp, definitions.h]
2020-01-12 Added readme and minor fix in documentation
    [Menu.cpp, powerModes.cpp]
2020-01-15 Fixed for V2 of epd, added definition to keep backward compatibility, using the refresh time (so extra 600-800ms of processor time every second, yay!)
    [VarioSW.cpp, definitions.h]
2020-01-19 Fixed some bugs related to new EPD version, added PCB and some hardware related stuff
    [SensorsPower.SchDoc, Vario_PCB.PrjPcb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]
2020-01-19 Fixed some epd v2 bugs... again...
    [VarioSW.cpp, powerModes.cpp]
2020-01-22 fixed capacitor values for crystals
    [Vario_sch.SchDoc]
2021-03-11 Fixed flash erase issue
    [serial_plotter.py]
2021-03-15 simplified debugging, changed ranges on IMU, removed some rubbish
2021-03-19 fixed increased consumption in power-down --bluetooth will not work now, will debug when i have a bluetooth module
    [Menu.cpp, powerModes.cpp]
2021-12-07 PCB Version 1.5
    [SensorsPower.SchDoc, Vario_PCB.PrjPcb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]
