Jenatko/VariYO/(notices)

Notices in the files:
VarioSW_as/VarioSW/src/periph/MS5611.cpp:
This program is free software: you can redistribute it and/or modify
it under the terms of the version 3 GNU General Public License as
published by the Free Software Foundation.
